kaybarkbark/gbpunk/hardware/gbpunk/gbpunk-back.png

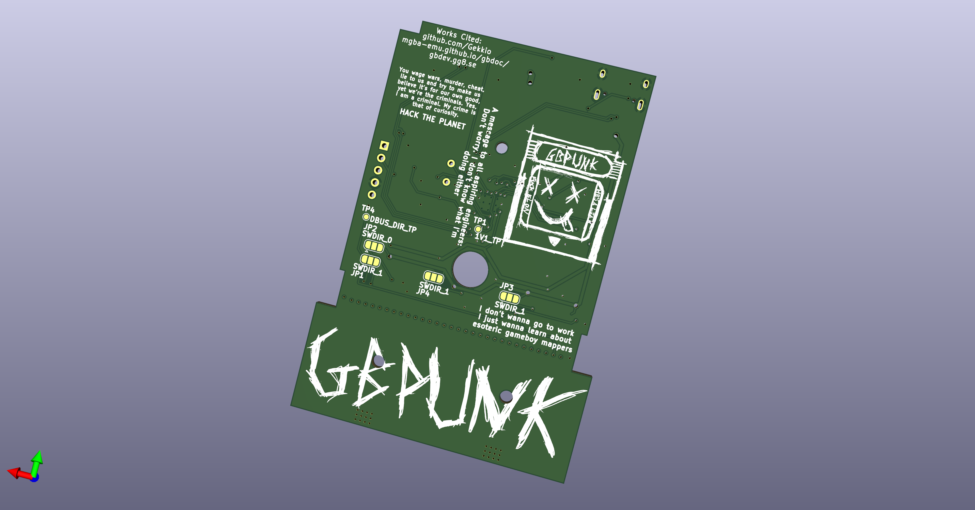
hardware/gbpunk/gbpunk-back.png
