kaybarkbark/gbpunk/hardware/gbpunk/gbpunk-front.png

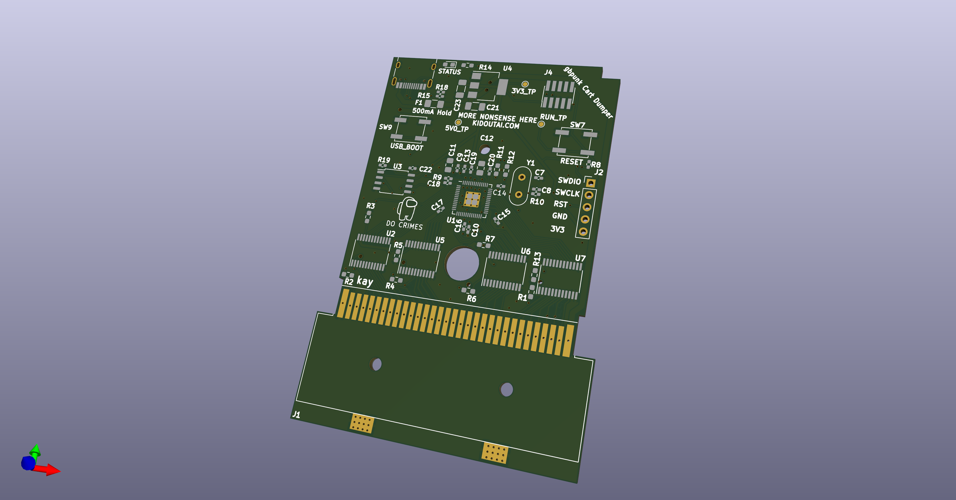
hardware/gbpunk/gbpunk-front.png
