kaybarkbark/gbpunk/art/name.png

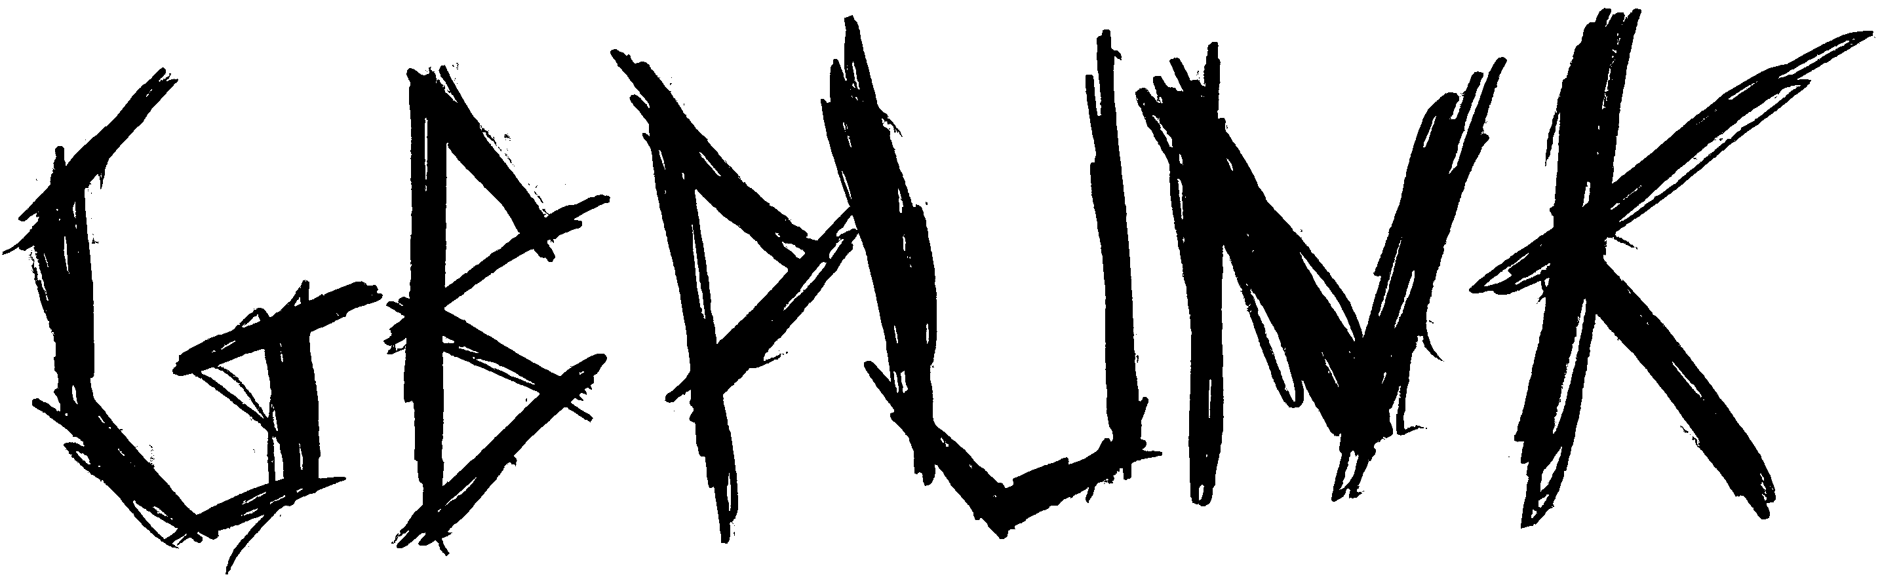
art/name.png
