kaybarkbark/gbpunk/hardware/gbpunk/gbpunk.kicad_pcb

## KiCad design hardware/gbpunk/gbpunk.kicad_pcb (2023-06-28)

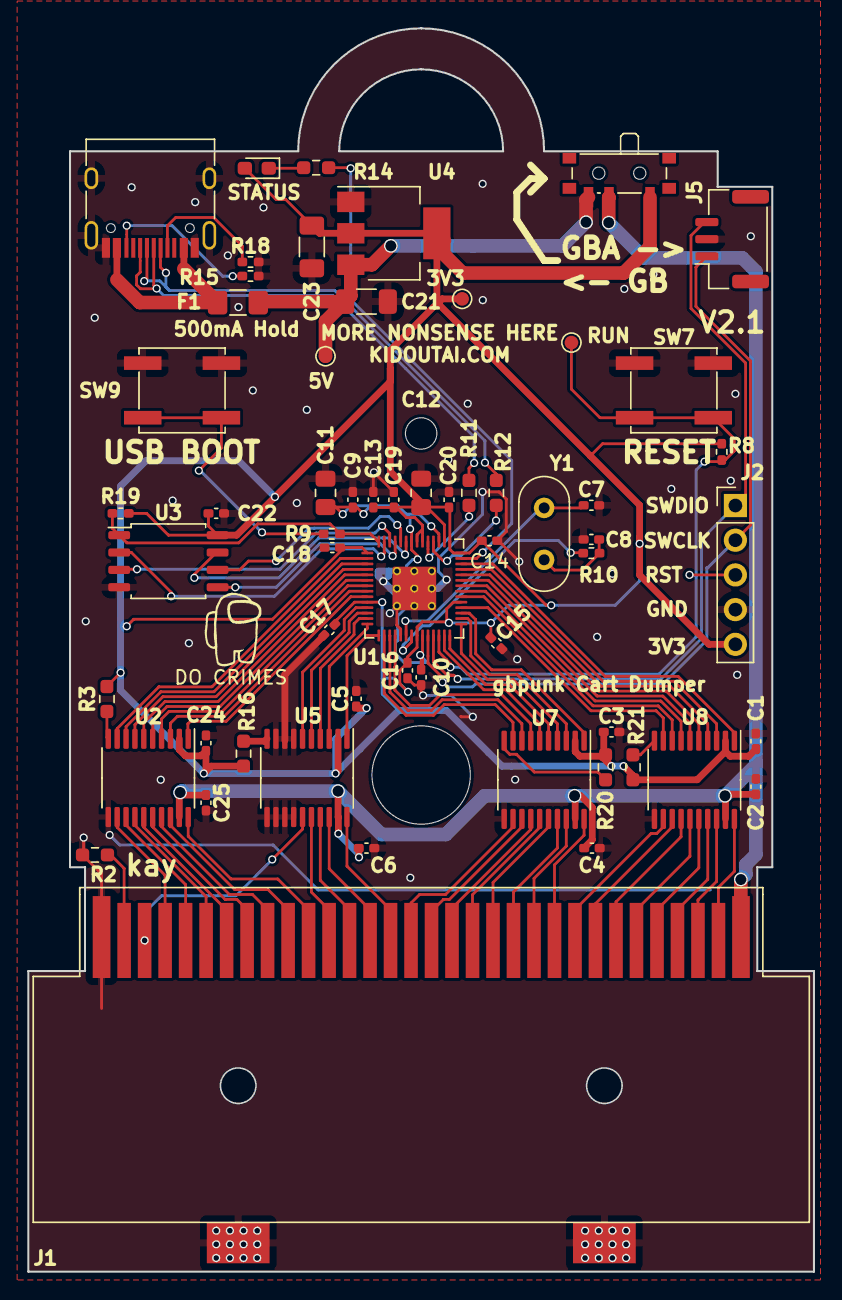
[picture p4: board gbpunk.kicad_pcb from above]

Board: 2 copper layers, 57.5 x 91.0 mm, 62 parts (1 on the bottom side), 89 nets.

Parts:
C1, C2, C3, C4, C5, C6, C9, C10, C13, C14, C15, C16, C17, C18, C19, C20, C22, C24, C25: 100nF; C_0402_1005Metric_Pad0.74x0.62mm_HandSolder
C7, C8: 27pF; C_0402_1005Metric_Pad0.74x0.62mm_HandSolder
C11, C12: 1uF; C_0805_2012Metric_Pad1.18x1.45mm_HandSolder
C21, C23: 10uF; C_1206_3216Metric_Pad1.33x1.80mm_HandSolder
D1: STATUS; LED_0603_1608Metric_Pad1.05x0.95mm_HandSolder
F1: 500mA Hold; Fuse_1206_3216Metric_Pad1.42x1.75mm_HandSolder
J1: CART; gbpunk_aliexpress_gb_connector
J2: SWD_CONNECTOR; PinHeader_1x05_P2.54mm_Vertical
J5: DEBUG_CONNECTOR; JST_GH_SM03B-GHS-TB_1x03-1MP_P1.25mm_Horizontal
MK1: DNF; MountingHole_7.2mm
MK2: DNF; MountingHole_2.3mm
P1: USB_C_CONNECTOR; USB_C_Receptacle_HRO_TYPE-C-31-M-12
R2, R3, R16, R20, R21: 1k; R_0603_1608Metric_Pad0.98x0.95mm_HandSolder
R8, R19: 10k; R_0402_1005Metric_Pad0.72x0.64mm_HandSolder
R9, R10: 1k; R_0402_1005Metric_Pad0.72x0.64mm_HandSolder
R11, R12: 27; R_0603_1608Metric_Pad0.98x0.95mm_HandSolder
R14: 330; R_0603_1608Metric_Pad0.98x0.95mm_HandSolder
R15, R18: 56k; R_0402_1005Metric_Pad0.72x0.64mm_HandSolder
SW1: CART_SELECT; SW_SPDT_PCM12
SW7: RESET; SW_SPST_EVPBF
SW9: USB_BOOT; SW_SPST_EVPBF
TP1: 1V1_TP; TestPoint_Pad_D1.0mm
TP2: RUN_TP; TestPoint_Pad_D1.0mm
TP3: 3V3_TP; TestPoint_Pad_D1.0mm
TP5: 5V0_TP; TestPoint_Pad_D1.0mm
U1: RP2040; RP2040-QFN-56
U2, U5, U7, U8: TXS0108EPW; TSSOP-20_4.4x6.5mm_P0.65mm
U3: W25Q128JVS; SOIC-8_5.23x5.23mm_P1.27mm
U4: NCP1117-3.3_SOT223; SOT-223-3_TabPin2
Y1: 12MHz; Crystal_HC52-8mm_Vertical

Connections:
+1V1: C9.1, C10.1, C11.1, TP1.1, U1.23 (DVDD), U1.45 (VREG_VOUT), U1.50 (DVDD)
+3.3V: C1.1, C3.1, C5.1, C12.1, C13.1, C14.1, C15.1, C16.1, C17.1, C18.1, C19.1, C20.1, C22.1, C23.1, C24.1, D1.2 (A), J2.5, R3.2, R8.1, R16.2, R19.1, R20.2, R21.2, SW1.1 (A), TP3.1, U1.1 (IOVDD), U1.10 (IOVDD), U1.22 (IOVDD), U1.33 (IOVDD), U1.42 (IOVDD), U1.43 (ADC_AVDD), U1.44 (VREG_IN), U1.48 (USB_VDD), U1.49 (IOVDD), U2.2 (VCCA), U3.8 (VCC), U4.2 (VO), U5.2 (VCCA), U7.2 (VCCA), U8.2 (VCCA)
+5V: C21.1, F1.1, SW1.3 (C), TP5.1, U4.3 (VI)
/A0: J1.6, U8.15 (B5)
/A0_L: U1.36 (GPIO24), U8.6 (A5)
/A1: J1.7, U8.14 (B6)
/A1_L: U1.35 (GPIO23), U8.7 (A6)
/A2: J1.8, U8.13 (B7)
/A2_L: U1.34 (GPIO22), U8.8 (A7)
/A3: J1.9, U8.12 (B8)
/A3_L: U1.32 (GPIO21), U8.9 (A8)
/A4: J1.10, U7.20 (B1)
/A4_L: U1.31 (GPIO20), U7.1 (A1)
/A5: J1.11, U7.18 (B2)
/A5_L: U1.30 (GPIO19), U7.3 (A2)
/A6: J1.12, U7.17 (B3)
/A6_L: U1.29 (GPIO18), U7.4 (A3)
/A7: J1.13, U7.16 (B4)
/A7_L: U1.28 (GPIO17), U7.5 (A4)
/A8: J1.14, U7.15 (B5)
/A8_L: U1.27 (GPIO16), U7.6 (A5)
/A9: J1.15, U7.14 (B6)
/A9_L: U1.18 (GPIO15), U7.7 (A6)
/A10: J1.16, U7.13 (B7)
/A10_L: U1.17 (GPIO14), U7.8 (A7)
/A11: J1.17, U7.12 (B8)
/A11_L: U1.16 (GPIO13), U7.9 (A8)
/A12: J1.18, U5.20 (B1)
/A12_L: U1.15 (GPIO12), U5.1 (A1)
/A13: J1.19, U5.18 (B2)
/A13_L: U1.14 (GPIO11), U5.3 (A2)
/A14: J1.20, U5.17 (B3)
/A14_L: U1.13 (GPIO10), U5.4 (A3)
/A15: J1.21, U5.16 (B4)
/A15_L: U1.12 (GPIO9), U5.5 (A4)
/CART_VCC: C2.1, C4.1, C6.1, C25.1, J1.1, SW1.2 (B), U2.19 (VCCB), U5.19 (VCCB), U7.19 (VCCB), U8.19 (VCCB)
/CLK: J1.2, U8.20 (B1)
/CLK_L: U1.40 (GPIO28_ADC2), U8.1 (A1)
/D0: J1.22, U2.20 (B1)
/D0_L: U1.9 (GPIO7), U2.1 (A1)
/D1: J1.23, U2.18 (B2)
/D1_L: U1.8 (GPIO6), U2.3 (A2)
/D2: J1.24, U2.17 (B3)
/D2_L: U1.7 (GPIO5), U2.4 (A3)
/D3: J1.25, U2.16 (B4)
/D3_L: U1.6 (GPIO4), U2.5 (A4)
/D4: J1.26, U2.15 (B5)
/D4_L: U1.5 (GPIO3), U2.6 (A5)
/D5: J1.27, U2.14 (B6)
/D5_L: U1.4 (GPIO2), U2.7 (A6)
/D6: J1.28, U2.13 (B7)
/D6_L: U1.3 (GPIO1), U2.8 (A7)
/D7: J1.29, U2.12 (B8)
/D7_L: U1.2 (GPIO0), U2.9 (A8)
/QSPI_CLK: U1.52 (QSPI_SCLK), U3.6 (CLK)
/QSPI_D0: U1.53 (QSPI_SD0), U3.5 (DI(IO0))
/QSPI_D1: U1.55 (QSPI_SD1), U3.2 (DO(IO1))
/QSPI_D2: U1.54 (QSPI_SD2), U3.3 (IO2)
/QSPI_D3: U1.51 (QSPI_SD3), U3.7 (IO3)
/RST: J1.30, U5.15 (B5)
/RST_L: U1.11 (GPIO8), U5.6 (A5)
/RUN: J2.3, R8.2, SW7.2 (B), TP2.1, U1.26 (RUN)
/SWCLK: J2.2, J5.1, U1.24 (SWCLK)
/SWDIO: J2.1, J5.3, U1.25 (SWD)
/USB_DM: P1.A7 (D-), R12.1
/USB_DP: P1.A6 (D+), R11.1
/~CS_L: U1.37 (GPIO25), U8.5 (A4)
/~CS: J1.5, U8.16 (B4)
/~QSPI_CS: R9.1, R19.2, U1.56 (QSPI_SS), U3.1 (~CS)
/~RD_L: U1.38 (GPIO26_ADC0), U8.4 (A3)
/~RD: J1.4, U8.17 (B3)
/~USB_BOOT: R9.2, SW9.2 (B)
/~WR_L: U1.39 (GPIO27_ADC1), U8.3 (A2)
/~WR: J1.3, U8.18 (B2)
GND: C1.2, C2.2, C3.2, C4.2, C5.2, C6.2, C7.2, C8.2, C9.2, C10.2, C11.2, C12.2, C13.2, C14.2, C15.2, C16.2, C17.2, C18.2, C19.2, C20.2, C21.2, C22.2, C23.2, C24.2, C25.2, J1.32, J2.4, J5.2, P1.A1 (GND), P1.A12 (GND), P1.B1 (GND), P1.B12 (GND), P1.S1 (SHIELD), R2.2, R15.2, R18.2, SW7.1 (A), SW9.1 (A), U1.19 (TESTEN), U1.57 (GND), U2.11 (GND), U3.4 (GND), U4.1 (GND), U5.7 (A6), U5.8 (A7), U5.9 (A8), U5.11 (GND), U5.12 (B8), U5.13 (B7), U5.14 (B6), U7.11 (GND), U8.11 (GND)
unnamed: C8.1, R10.1, Y1.1
unnamed: D1.1 (K), R14.1
unnamed: J1.31, R2.1
unnamed: P1.A5 (CC), R18.1
unnamed: R14.2, U1.41 (GPIO29_ADC3)
unnamed: R12.2, U1.46 (USB_DM)
unnamed: R11.2, U1.47 (USB_DP)
unnamed: C7.1, U1.20 (XIN), Y1.2
unnamed: R10.2, U1.21 (XOUT)
unnamed: R3.1, U2.10 (OE)
unnamed: R16.1, U5.10 (OE)
unnamed: R20.1, U7.10 (OE)
unnamed: R21.1, U8.10 (OE)
VBUS: F1.2, P1.A4 (VBUS), P1.A9 (VBUS), P1.B4 (VBUS), P1.B9 (VBUS)
