kaybarkbark/gbpunk/hardware/flashcart/flashcart/flashcart.kicad_pcb

## KiCad design hardware/flashcart/flashcart/flashcart.kicad_pcb (2023-06-28)

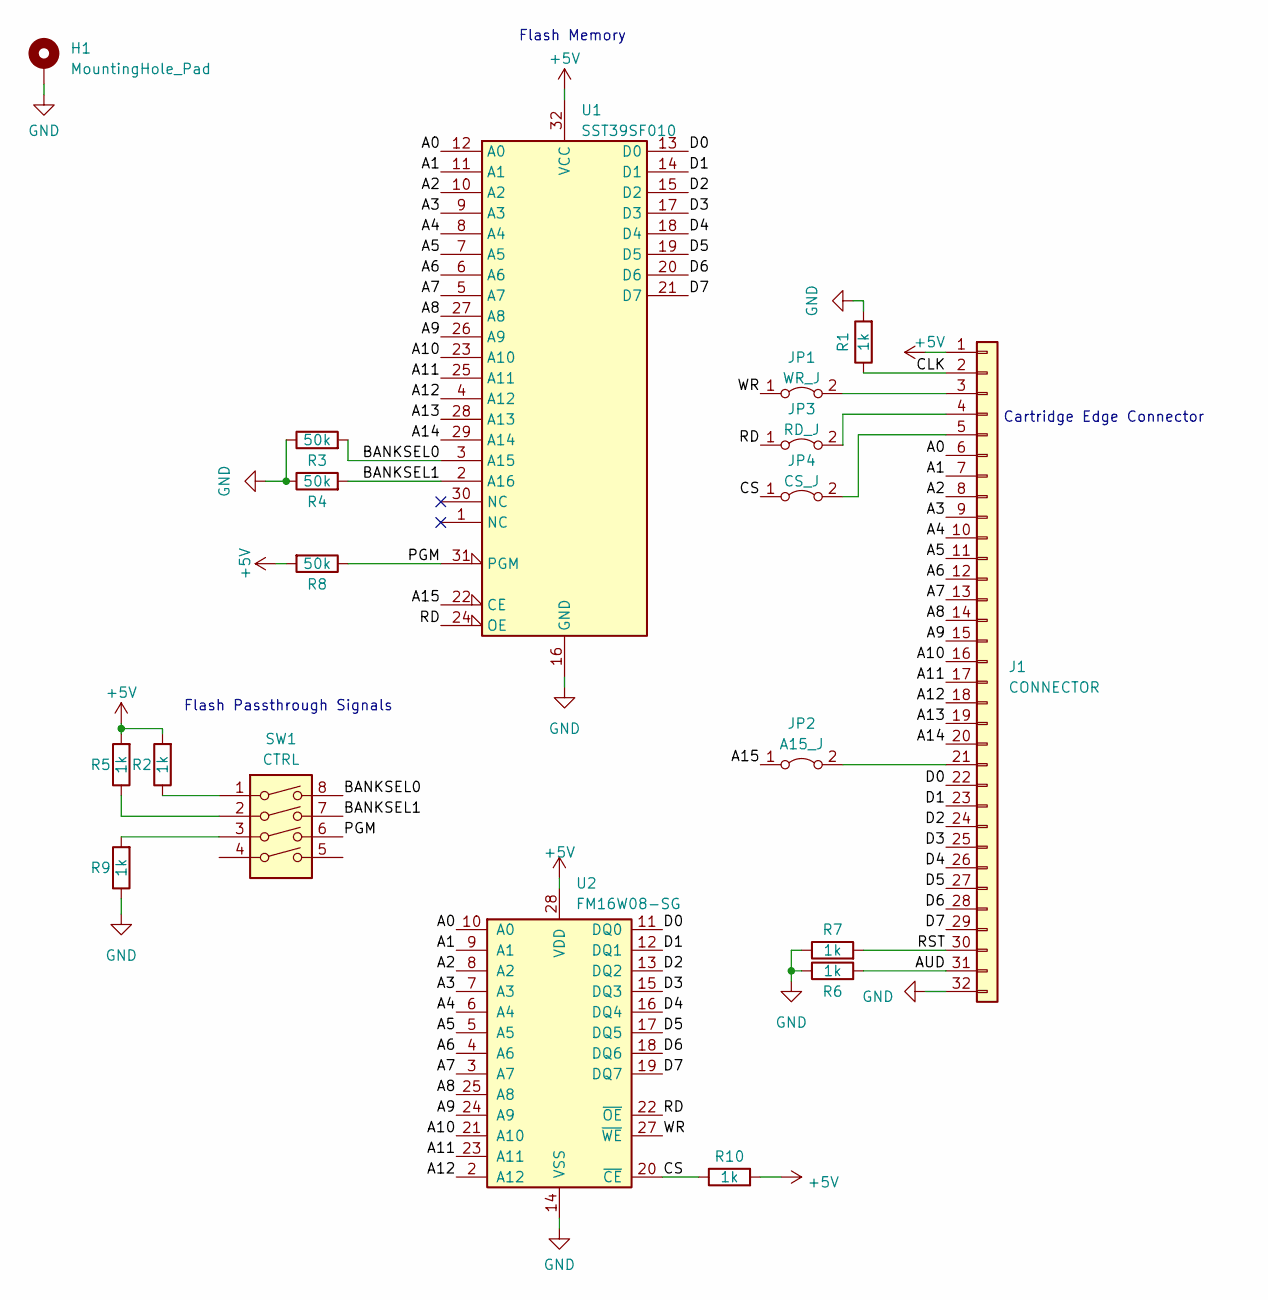
[picture p5: schematic flashcart.kicad_sch]

Parts:
H1: MountingHole_Pad; MountingHole_5mm_Pad_Via
J1: CONNECTOR; GameBoy_Cartridge_1x32_P1.50mm_Edge
JP1: WR_J; SolderJumper-2_P1.3mm_Bridged_RoundedPad1.0x1.5mm
JP2: A15_J; SolderJumper-2_P1.3mm_Bridged_RoundedPad1.0x1.5mm
JP3: RD_J; SolderJumper-2_P1.3mm_Bridged_RoundedPad1.0x1.5mm
JP4: CS_J; SolderJumper-2_P1.3mm_Bridged_RoundedPad1.0x1.5mm
R1, R2, R5, R6, R7, R9, R10: 1k; R_0805_2012Metric_Pad1.20x1.40mm_HandSolder
R3, R4, R8: 50k; R_0805_2012Metric_Pad1.20x1.40mm_HandSolder
SW1: CTRL; SW_DIP_SPSTx04_Slide_KingTek_DSHP04TS_W7.62mm_P1.27mm
U1: SST39SF010; TSOP-I-32_14.4x8mm_P0.5mm
U2: FM16W08-SG; SOIC-28W_7.5x17.9mm_P1.27mm

Connections:
+5V: J1.1, R2.2, R5.2, R8.2, R10.2, U1.32 (VCC), U2.28 (VDD)
/A0: J1.6, U1.12 (A0), U2.10 (A0)
/A1: J1.7, U1.11 (A1), U2.9 (A1)
/A2: J1.8, U1.10 (A2), U2.8 (A2)
/A3: J1.9, U1.9 (A3), U2.7 (A3)
/A4: J1.10, U1.8 (A4), U2.6 (A4)
/A5: J1.11, U1.7 (A5), U2.5 (A5)
/A6: J1.12, U1.6 (A6), U2.4 (A6)
/A7: J1.13, U1.5 (A7), U2.3 (A7)
/A8: J1.14, U1.27 (A8), U2.25 (A8)
/A9: J1.15, U1.26 (A9), U2.24 (A9)
/A10: J1.16, U1.23 (A10), U2.21 (A10)
/A11: J1.17, U1.25 (A11), U2.23 (A11)
/A12: J1.18, U1.4 (A12), U2.2 (A12)
/A13: J1.19, U1.28 (A13)
/A14: J1.20, U1.29 (A14)
/A15: JP2.1 (A), U1.22 (CE)
/AUD: J1.31, R6.2
/BANKSEL0: R3.2, SW1.8, U1.3 (A15)
/BANKSEL1: R4.2, SW1.7, U1.2 (A16)
/CLK: J1.2, R1.1
/CS: JP4.1 (A), R10.1, U2.20 (~CE)
/D0: J1.22, U1.13 (D0), U2.11 (DQ0)
/D1: J1.23, U1.14 (D1), U2.12 (DQ1)
/D2: J1.24, U1.15 (D2), U2.13 (DQ2)
/D3: J1.25, U1.17 (D3), U2.15 (DQ3)
/D4: J1.26, U1.18 (D4), U2.16 (DQ4)
/D5: J1.27, U1.19 (D5), U2.17 (DQ5)
/D6: J1.28, U1.20 (D6), U2.18 (DQ6)
/D7: J1.29, U1.21 (D7), U2.19 (DQ7)
/PGM: R8.1, SW1.6, U1.31 (PGM)
/RD: JP3.1 (A), U1.24 (OE), U2.22 (~OE)
/RST: J1.30, R7.2
/WR: JP1.1 (A), U2.27 (~WE)
GND: H1.1, J1.32, R1.2, R3.1, R4.1, R6.1, R7.1, R9.1, U1.16 (GND), U2.14 (VSS)
unnamed: J1.3, JP1.2 (B)
unnamed: J1.4, JP3.2 (B)
unnamed: J1.5, JP4.2 (B)
unnamed: J1.21, JP2.2 (B)
unnamed: R2.1, SW1.1
unnamed: R5.1, SW1.2
unnamed: R9.2, SW1.3

Notes on the sheet:
Cartridge Edge Connector
Flash Memory
Flash Passthrough Signals

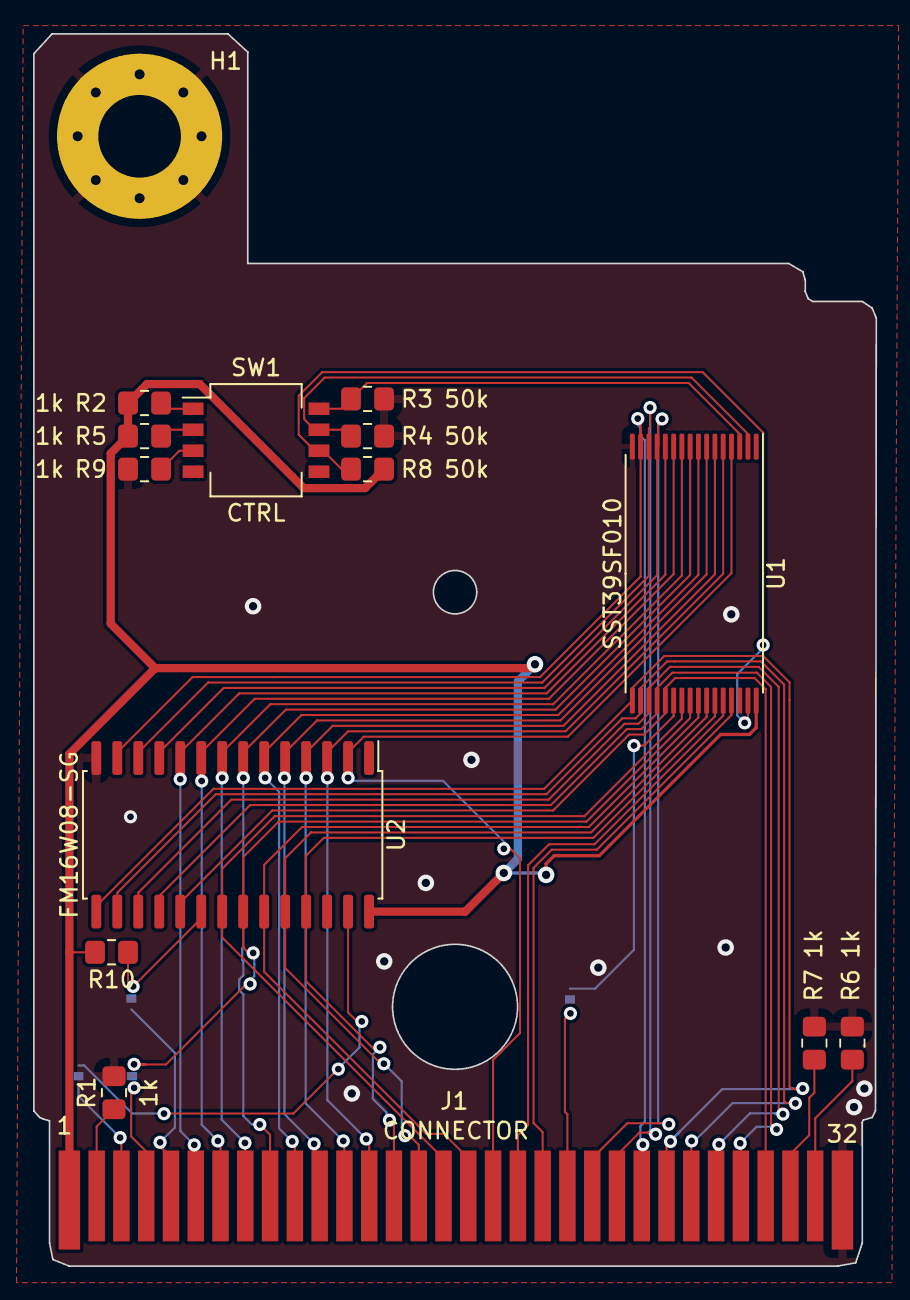
[picture p6: board flashcart.kicad_pcb from above]

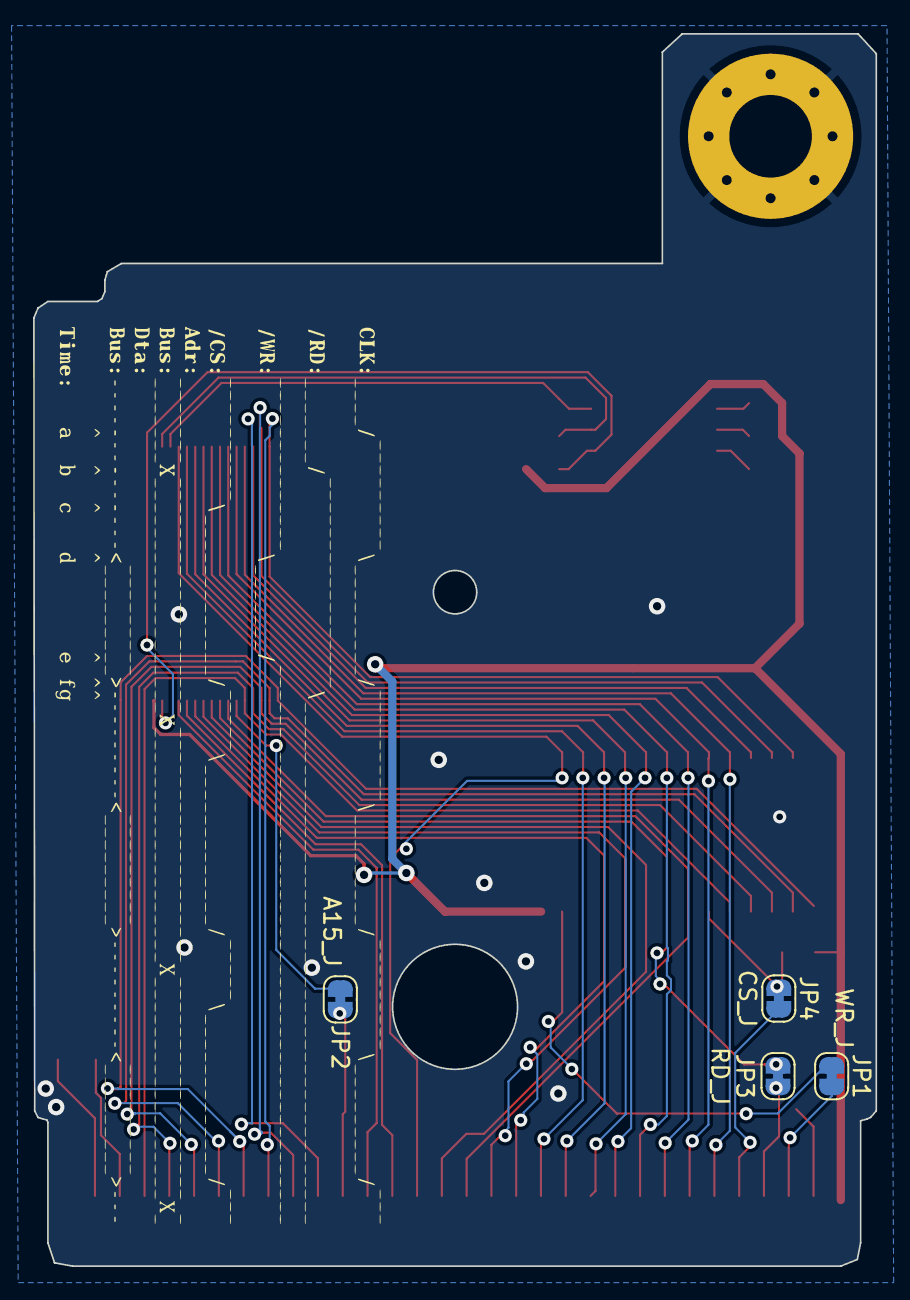
[picture p7: board flashcart.kicad_pcb from below]

Board: 2 copper layers, 51.0 x 74.6 mm, 19 parts (4 on the bottom side), 42 nets.
