kaybarkbark/gbpunk/hardware/interposer/interposer.kicad_pcb

## KiCad design hardware/interposer/interposer.kicad_pcb (2023-01-16)

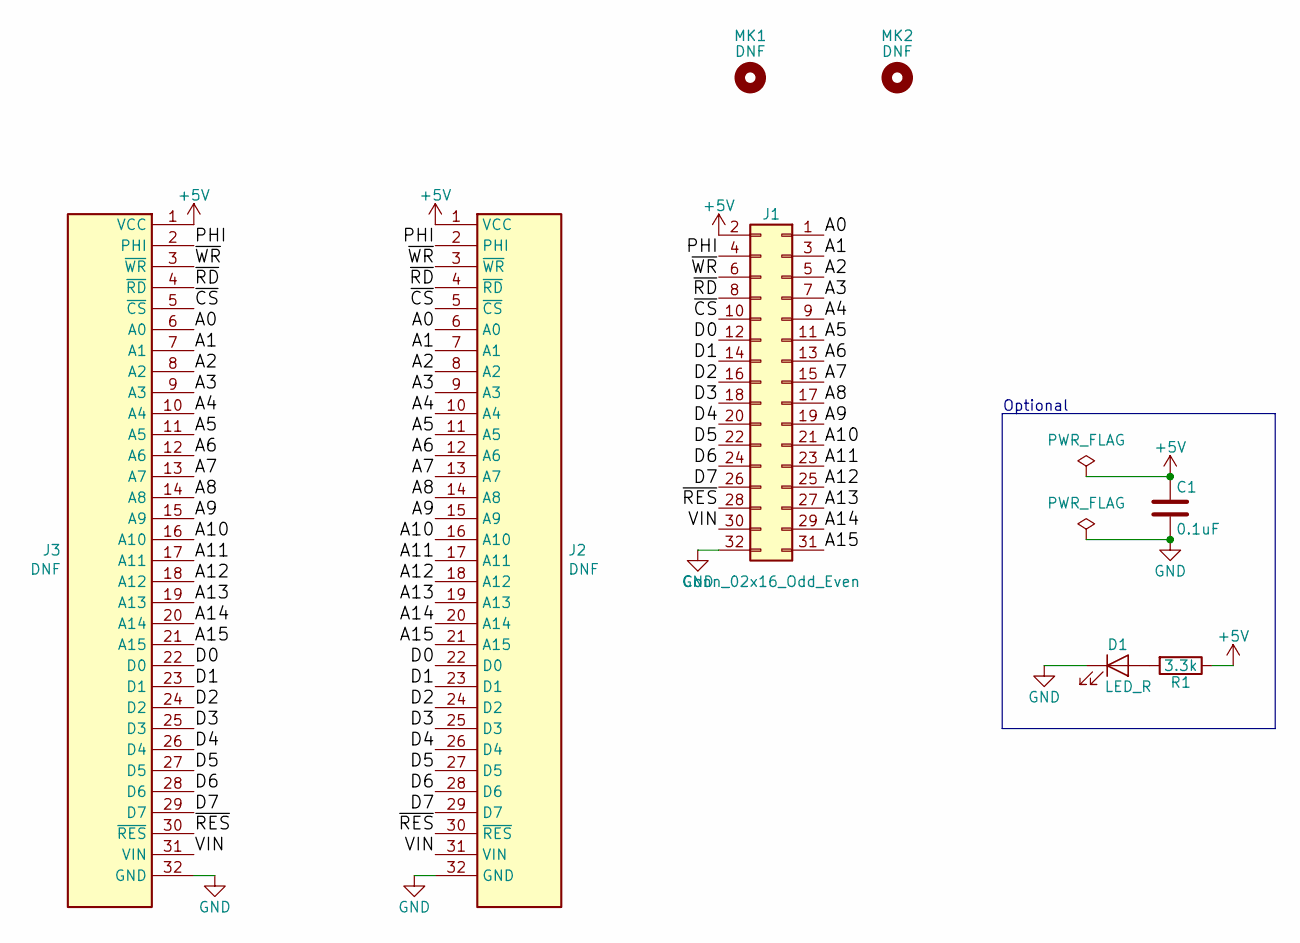
[picture p8: schematic interposer.kicad_sch, GB-BRK-CART]

Parts:
C1: 0.1uF; C_0603_1608Metric; Rating 16V X5R; MPN 06035C104KAT4A
D1: LED_R; LED_0603_1608Metric; MPN 150060SS75000
J1: Conn_02x16_Odd_Even; PinHeader_2x16_P2.54mm_Vertical_SMD; MPN 15-91-0800
J2: DNF; GameBoy_Cartridge_1x32_P1.50mm_Edge
J3: DNF; GameBoy_Cartridge_DSLite_1x32_P1.50mm_Socket_Horizontal
MK1: DNF; MountingHole_7.2mm
MK2: DNF; MountingHole_2.3mm
R1: 3.3k; R_0603_1608Metric; Rating 1/10W 5%; MPN CRCW06033K30JNEB

Connections:
+5V: C1.1, J1.2, J2.1 (VCC), J3.1 (VCC), R1.1
/A0: J1.1, J2.6 (A0), J3.6 (A0)
/A1: J1.3, J2.7 (A1), J3.7 (A1)
/A2: J1.5, J2.8 (A2), J3.8 (A2)
/A3: J1.7, J2.9 (A3), J3.9 (A3)
/A4: J1.9, J2.10 (A4), J3.10 (A4)
/A5: J1.11, J2.11 (A5), J3.11 (A5)
/A6: J1.13, J2.12 (A6), J3.12 (A6)
/A7: J1.15, J2.13 (A7), J3.13 (A7)
/A8: J1.17, J2.14 (A8), J3.14 (A8)
/A9: J1.19, J2.15 (A9), J3.15 (A9)
/A10: J1.21, J2.16 (A10), J3.16 (A10)
/A11: J1.23, J2.17 (A11), J3.17 (A11)
/A12: J1.25, J2.18 (A12), J3.18 (A12)
/A13: J1.27, J2.19 (A13), J3.19 (A13)
/A14: J1.29, J2.20 (A14), J3.20 (A14)
/A15: J1.31, J2.21 (A15), J3.21 (A15)
/D0: J1.12, J2.22 (D0), J3.22 (D0)
/D1: J1.14, J2.23 (D1), J3.23 (D1)
/D2: J1.16, J2.24 (D2), J3.24 (D2)
/D3: J1.18, J2.25 (D3), J3.25 (D3)
/D4: J1.20, J2.26 (D4), J3.26 (D4)
/D5: J1.22, J2.27 (D5), J3.27 (D5)
/D6: J1.24, J2.28 (D6), J3.28 (D6)
/D7: J1.26, J2.29 (D7), J3.29 (D7)
/PHI: J1.4, J2.2 (PHI), J3.2 (PHI)
/VIN: J1.30, J2.31 (VIN), J3.31 (VIN)
/~CS: J1.10, J2.5 (~CS), J3.5 (~CS)
/~RD: J1.8, J2.4 (~RD), J3.4 (~RD)
/~RES: J1.28, J2.30 (~RES), J3.30 (~RES)
/~WR: J1.6, J2.3 (~WR), J3.3 (~WR)
GND: C1.2, D1.1 (K), J1.32, J2.32 (GND), J3.32 (GND)
unnamed: D1.2 (A), R1.2

Notes on the sheet:
Optional

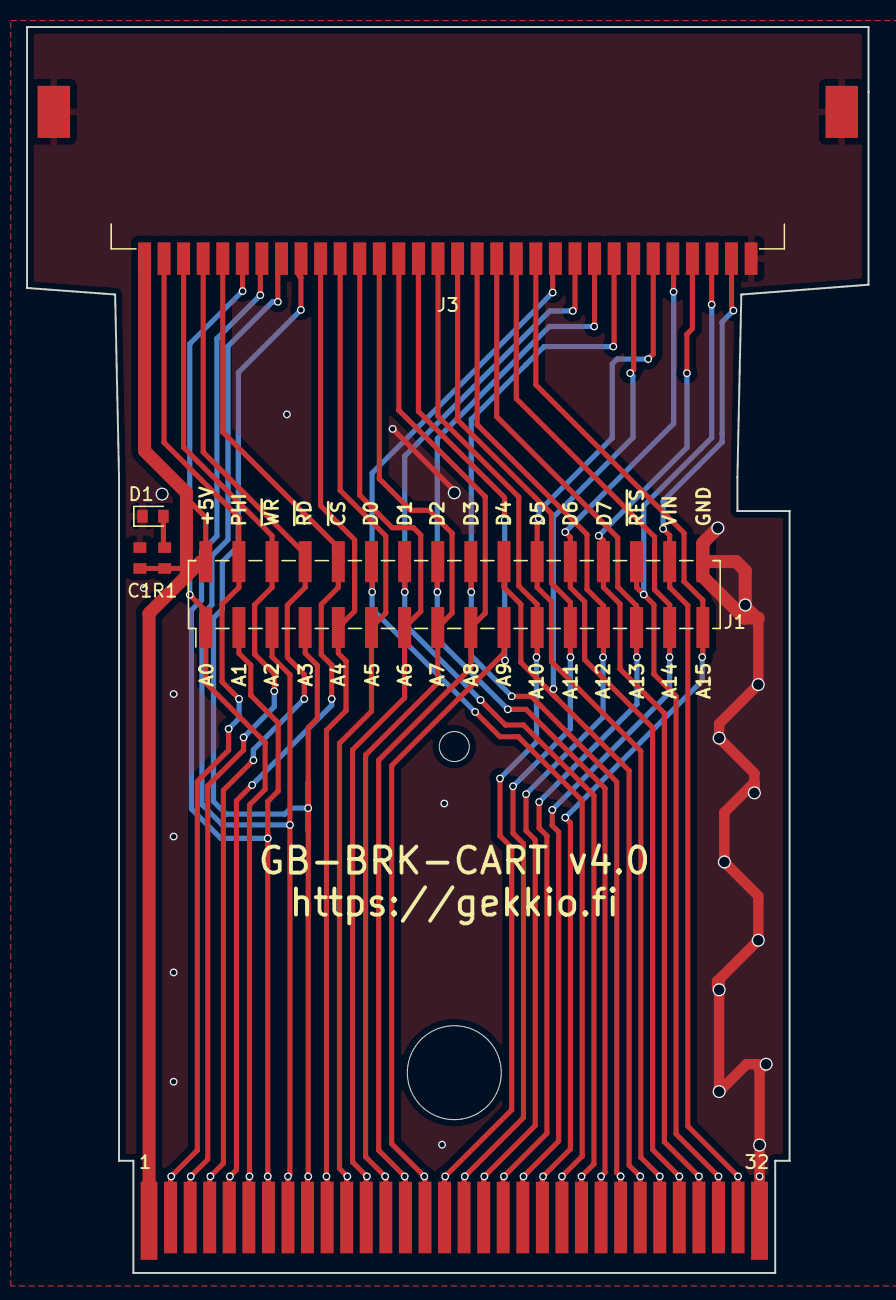
[picture p9: board interposer.kicad_pcb from above]

Board: 2 copper layers, 64.5 x 95.5 mm, 8 parts (0 on the bottom side), 33 nets.
