kaybarkbark/gbpunk/software/pins.h

#ifndef PINS_H_
#define PINS_H_


#define STATUS_LED  29

// Data Bus
#define D0          7
#define D1          6
#define D2          5
#define D3          4
#define D4          3
#define D5          2
#define D6          1
#define D7          0
#define NUM_D_PINS  8

// Control Pins
#define RST         8
#define CS          25
#define RD          26
#define WR          27
#define CLK         28

// Address Bus
#define A0          24
#define A1          23
#define A2          22
#define A3          21
#define A4          20
#define A5          19
#define A6          18
#define A7          17
#define A8          16
#define A9          15
#define A10         14
#define A11         13
#define A12         12
#define A13         11
#define A14         10
#define A15         9
#define NUM_A_PINS  16

// OLD
// // Non Cart Pins
// #define STATUS_LED  29

// // Data Bus
// #define D0          21
// #define D1          22
// #define D2          23
// #define D3          24
// #define D4          25
// #define D5          26
// #define D6          27
// #define D7          28
// #define NUM_D_PINS  8

// // Control Pins
// #define RST         20
// #define CS          3
// #define RD          2
// #define WR          1
// #define CLK         0

// // Address Bus
// #define A0          4
// #define A1          5
// #define A2          6
// #define A3          7
// #define A4          8
// #define A5          9
// #define A6          10
// #define A7          11
// #define A8          12
// #define A9          13
// #define A10         14
// #define A11         15
// #define A12         16
// #define A13         17
// #define A14         18
// #define A15         19
// #define NUM_A_PINS  16

#endif
