kaybarkbark/gbpunk/(commit log)

2022-09-01 sent to fab
    [bom.csv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]
2022-10-05 need an interposer to measure timings
    [bom.csv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]
2023-01-16 updated interposer
    [interposer-B_Cu.gbl, interposer-B_Mask.gbs, interposer-B_Paste.gbp, interposer-B_Silkscreen.gbo, interposer-Edge_Cuts.gm1, interposer-F_Cu.gtl, interposer-F_Mask.gts, interposer-F_Paste.gtp]
2023-02-28 fixed issues with the FAT and dumped out a ROM that is over 1MB
    [gb.c, gb.h, mbc5.c, mbc5.h, msc_disk.c]
2023-02-28 BIG RESTRUCTURE - seperated gb into gb and cart. gb is for low level pin twiddling and cart is for cart - made the cart a static object so it can just be used anywhere - wrote in code for the functio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
    [cart.c, cart.h, gb.c, gb.h, gbcam.c, main.c, mbc5.c, mbc5.h]
2023-03-02 working on an actual unit test framework that can be shared amongst all the carts
2023-03-05 sram doesn't hate me I am just dumb
    [main.c, mbc5.c, mbc5.h, msc_disk.c, unit_tests.c]
2023-03-06 fixed a bug in the FAT chain generator where the terminating entries were getting created in the wrong place, started work on the gbcam interface
    [cart.c, gbcam.c, gbcam.h, msc_disk.c]
2023-03-12 gonna start messing with the filesystem driver, need a clean start
2023-03-13 fixed a bug where the FAT chain got generated wrong on small files (1 cluster large)
    [msc_disk.c]
2023-03-19 going slow now, swapped enums out for changeable file indexes
    [msc_disk.c]
2023-03-24 Fixed mbc3 rom flashing but I do not know how
    [main.c, msc_disk.c, scratch.c]
2023-03-25 Fixed mbc1, on to mbc2
    [cart.c]
2023-03-27 gotta swap all the pins now :(
    [gbpunk.kicad_sch]
2023-03-27 big PCB reroute so the connector is not upside down
    [gbpunk.kicad_pcb, gbpunk.kicad_sch]
2023-03-28 wrote a python lib to decode game metadata from roms and dump to CSVs, should aid in finding cheap carts to test functionality with
    [eu_games.csv, japan_games.csv, proto-unlisc.csv, revisions.csv, usa_games.csv]
2023-04-02 updated the board
    [gbpunk.kicad_pcb]
2023-04-02 orderd boards for V2
    [bom-old.csv, bom.csv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]
2023-04-02 list of all the games I could find, mined for hardware capabilities
    [all_games.csv]
2023-06-28 added detection circuit and voltage switching for GBA/GB
    [flashcart.kicad_pcb, flashcart.kicad_sch, gbpunk.kicad_pcb, gbpunk.kicad_sch]
